Kunter-Bunt/masterthesis/thesis/titelseite.tex

%% Titelseite
%% Vorlage $Id: titelseite.tex 61 2012-05-03 13:58:03Z bless $

\def\usesf{}
\let\usesf\sffamily % diese Zeile auskommentieren für normalen TeX Font

\newsavebox{\Erstgutachter}
\savebox{\Erstgutachter}{\usesf Prof.~Dr.~H.~Schmeck}
\newsavebox{\Zweitgutachter}
\savebox{\Zweitgutachter}{\usesf Prof.~Dr.~?.~?????????}

\begin{titlepage}
\setlength{\unitlength}{1pt}
\begin{picture}(0,0)(85,770)

\end{picture}

\thispagestyle{empty}

%\begin{titlepage}
%%\let\footnotesize\small \let\footnoterule\relax
\begin{center}
\hbox{}
\vfill
{\usesf
{\huge\bfseries Zuverlässige funkbasierte Bereichsortung im Tunnelbau \par}
\vskip 1.8cm
Masterarbeit\\
von\\[2mm]
\vskip 1cm

{\large\bfseries Marius Wodtke\\}
\vskip 1.2cm
Institut für Angewandte Informatik und Formale Beschreibungsverfahren (AIFB)\\
der Fakultät für Informatik\\
%Universität Karlsruhe (TH)\\[2ex]
\vskip 3cm
\begin{tabular}{p{5.5cm}l}
Erstgutachter: & \usebox{\Erstgutachter} \\
%Zweitgutachter: & \usebox{\Zweitgutachter} \\
Betreuender~Mitarbeiter: & Dipl.-Inform.~K.~Bao \\
Externer Betreuer: & Andreas Ratzke (Ed. Züblin AG)\\
\end{tabular}
\vskip 3cm
Bearbeitungszeit:\qquad 02.~Oktober~2017 -- 11.~Januar~2018
}
\end{center}
\vfill
\end{titlepage}
%% Titelseite Ende

%%% Local Variables:
%%% mode: latex
%%% TeX-master: "thesis"
%%% End:
