Kunter-Bunt/masterthesis/thesis/iso-8859-1/titelseite.tex

%% Titelseite
%% Vorlage $Id: titelseite.tex 61 2012-05-03 13:58:03Z bless $

\def\usesf{}
\let\usesf\sffamily % diese Zeile auskommentieren für normalen TeX Font

\newsavebox{\Erstgutachter}
\savebox{\Erstgutachter}{\usesf Prof.~Dr.~?.~?????????}
\newsavebox{\Zweitgutachter}
\savebox{\Zweitgutachter}{\usesf Prof.~Dr.~?.~?????????}

\begin{titlepage}
\setlength{\unitlength}{1pt}
\begin{picture}(0,0)(85,770)

\end{picture}

\thispagestyle{empty}

%\begin{titlepage}
%%\let\footnotesize\small \let\footnoterule\relax
\begin{center}
\hbox{}
\vfill
{\usesf
{\huge\bfseries Hier steht der Titel der\\
                Diplom-/Studien-/Master-/""Bachelorarbeit \par}
\vskip 1.8cm
Diplomarbeit/Studienarbeit/Masterarbeit/Bachelorarbeit\\
von\\[2mm]
\vskip 1cm

{\large\bfseries Vorname Nachname\\}
\vskip 1.2cm
am Institut für Telematik\\
der Fakultät für Informatik\\
%Universität Karlsruhe (TH)\\[2ex]
\vskip 3cm
\begin{tabular}{p{5.5cm}l}
Erstgutachter: & \usebox{\Erstgutachter} \\
Zweitgutachter: & \usebox{\Zweitgutachter} \\
Betreuender~Mitarbeiter: & Dipl.-Inform.~?.~????????? \\
\end{tabular}
\vskip 3cm
Bearbeitungszeit:\qquad ??.~Monat~20?? -- ??.~Monat~20??
}
\end{center}
\vfill
\end{titlepage}
%% Titelseite Ende

%%% Local Variables: 
%%% mode: latex
%%% TeX-master: "thesis"
%%% End:
