Kunter-Bunt/masterthesis/thesis/iso-8859-1/einleitung.tex

%% Einleitung.tex
%% $Id: einleitung.tex 61 2012-05-03 13:58:03Z bless $
%%

\chapter{Einleitung}
\label{ch:Einleitung}
%% ==============================
Hinweis: In die Einleitung gehört die Motivation 
und Einleitung in die Problemstellung. Die Problemstellung
kann in der Analyse noch detaillierter beschrieben werden.

Bla fasel\ldots

%% ==============================
\section{Zielsetzung der Arbeit}
%% ==============================
\label{ch:Einleitung:sec:Zielsetzung}

Was ist die Aufgabe der Arbeit?

Bla fasel\ldots

%% ==============================
\section{Gliederung der Arbeit}
%% ==============================
\label{ch:Einleitung:sec:Gliederung}

Was enthalten die weiteren Kapitel?

Bla fasel\ldots

%%% Local Variables: 
%%% mode: latex
%%% TeX-master: "thesis"
%%% End:
