Kunter-Bunt/masterthesis/beamer/images/lis3dh.jpg

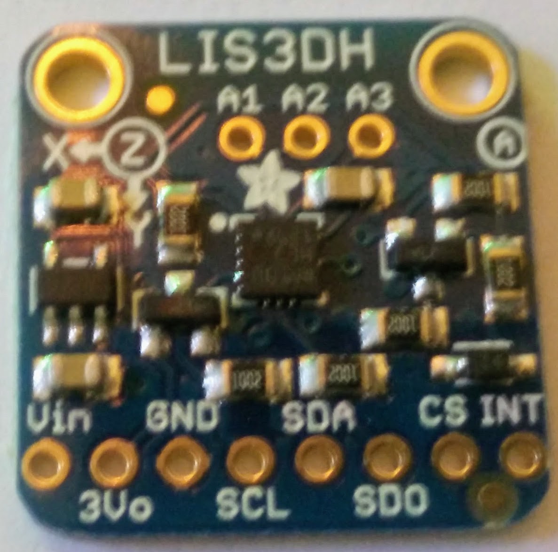
beamer/images/lis3dh.jpg
