Kunter-Bunt/masterthesis/beamer/images/lorafeather.jpg

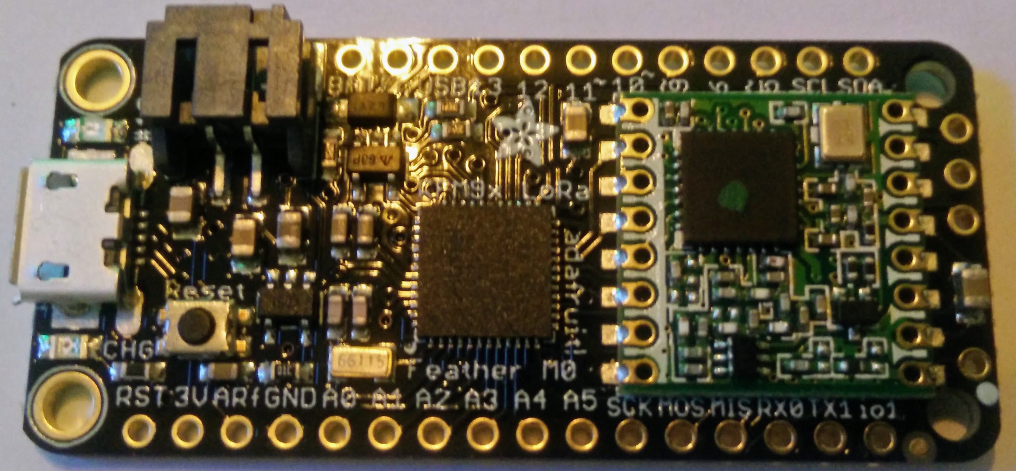
beamer/images/lorafeather.jpg
