Kunter-Bunt/masterthesis/beamer/images/nrf52layout.jpg

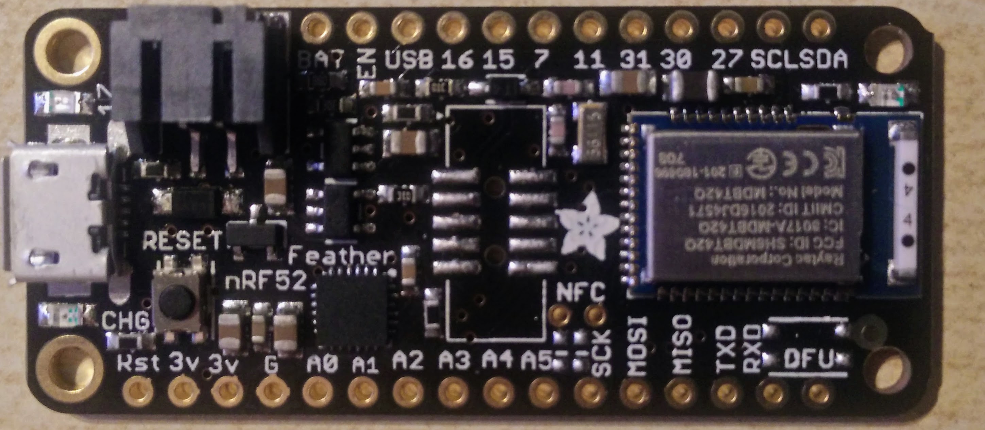
beamer/images/nrf52layout.jpg
