Kunter-Bunt/masterthesis/beamer/images/sendrecv.png

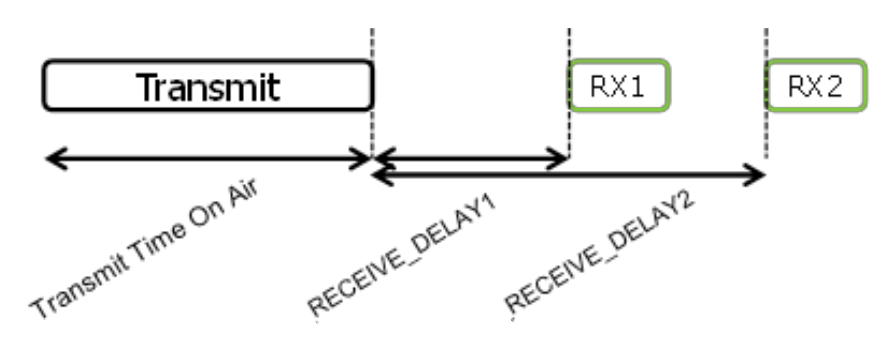
beamer/images/sendrecv.png
