Kunter-Bunt/masterthesis/beamer/plots/barcomp.png

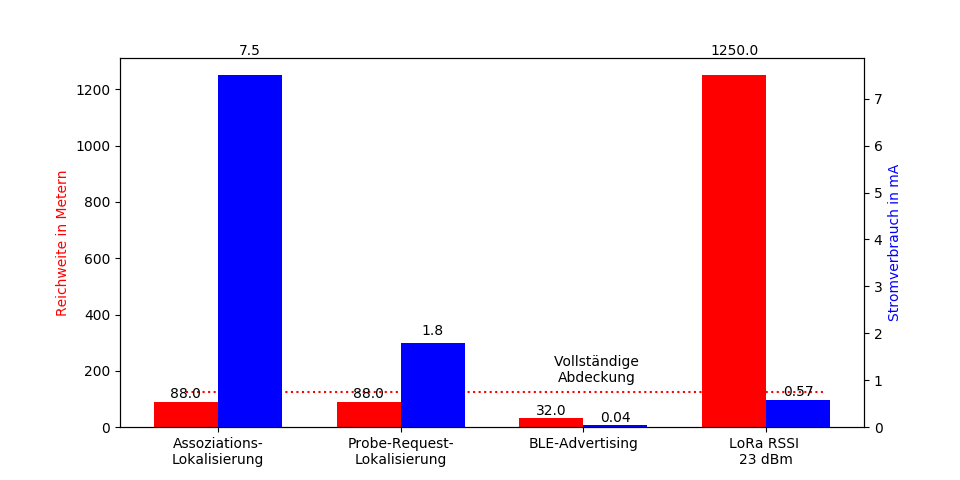
beamer/plots/barcomp.png
