Kunter-Bunt/masterthesis/beamer/plots/beacons.png

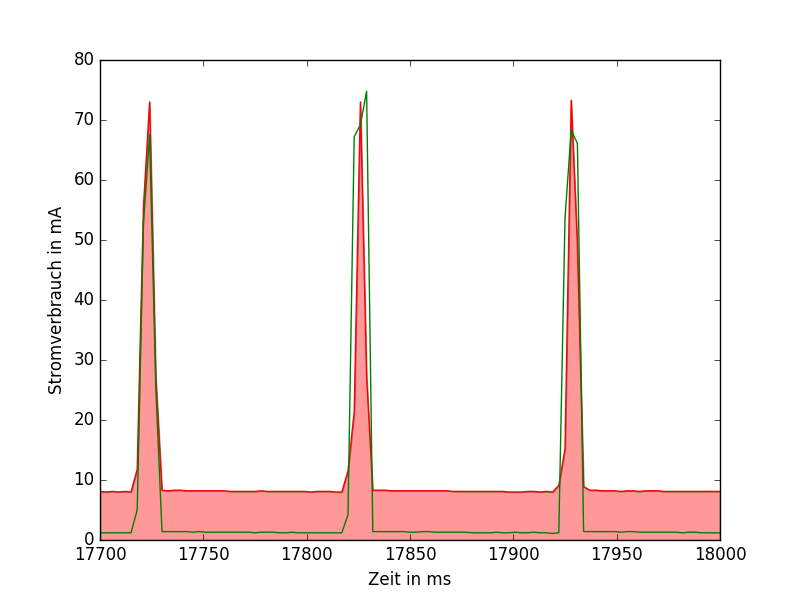
beamer/plots/beacons.png
