Kunter-Bunt/masterthesis/beamer/plots/llsalle.png

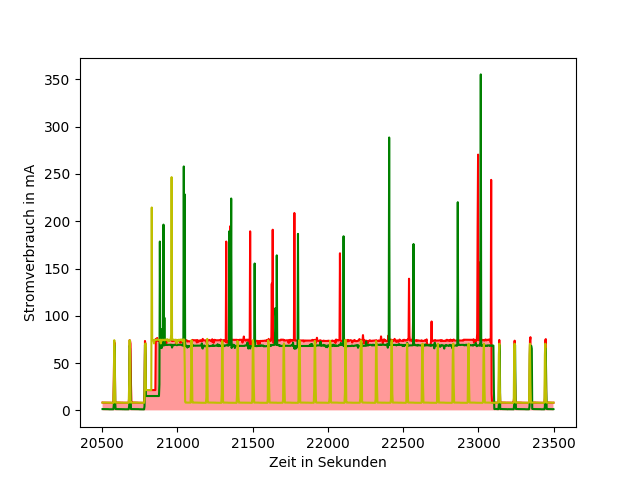
beamer/plots/llsalle.png
