Kunter-Bunt/masterthesis/beamer/plots/lora5send.png

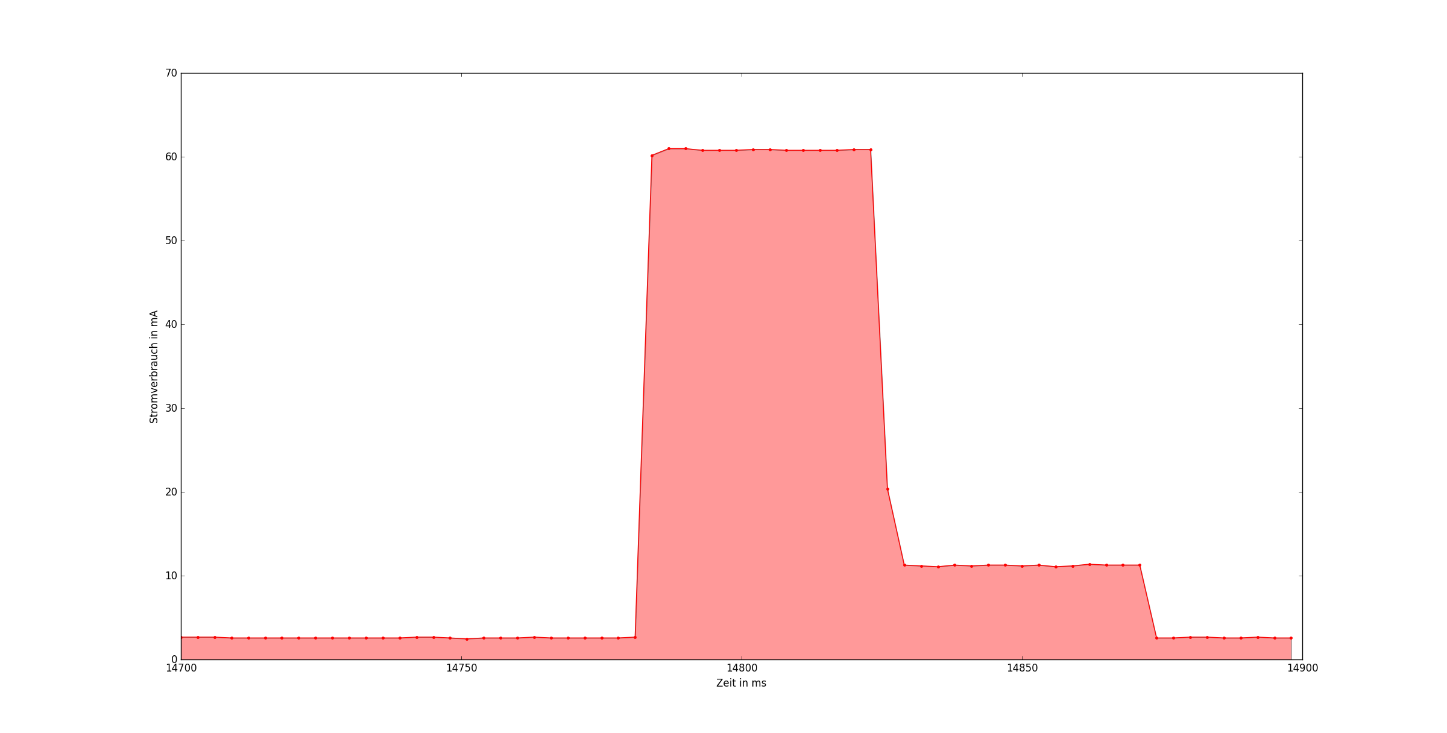
beamer/plots/lora5send.png
