Kunter-Bunt/masterthesis/beamer/plots/lora23send.png

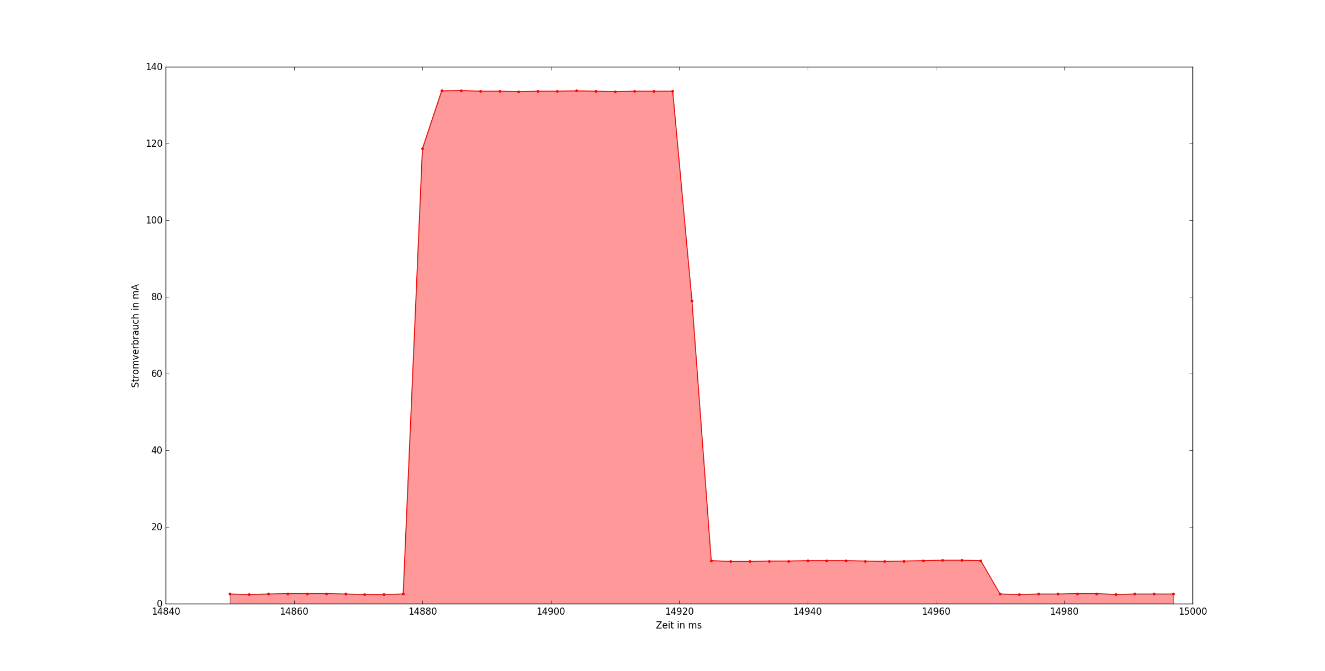
beamer/plots/lora23send.png
