Kunter-Bunt/masterthesis/beamer/plots/wifills1ch.png

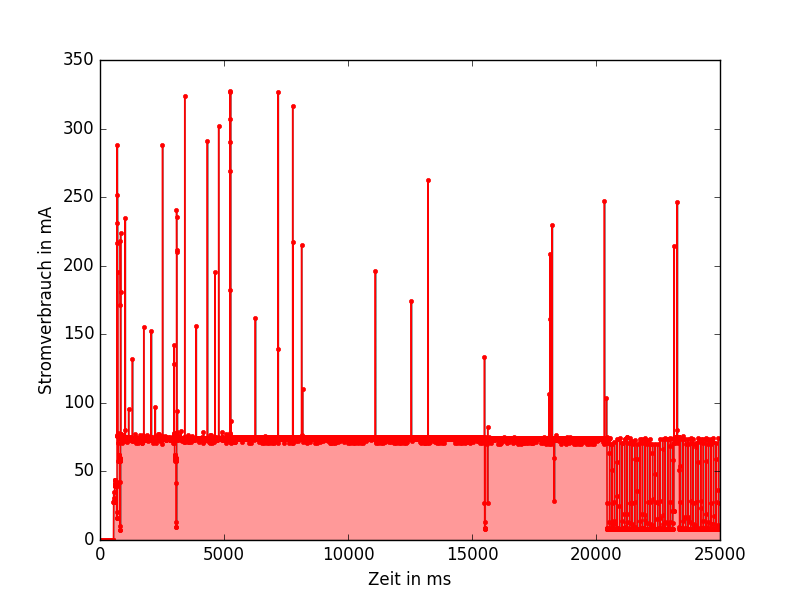
beamer/plots/wifills1ch.png
