Kunter-Bunt/masterthesis/thesis/ipes/resources/bluetooth-670069_640.png

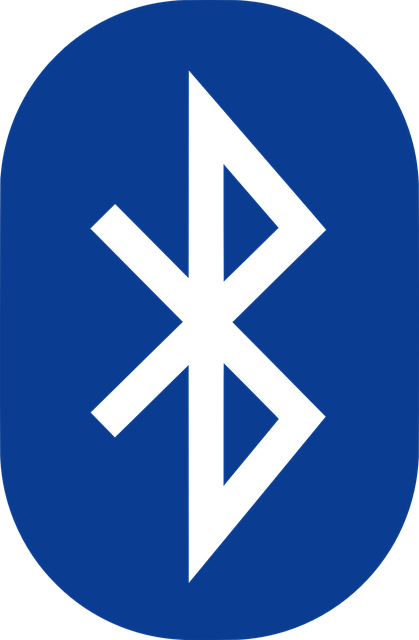
thesis/ipes/resources/bluetooth-670069_640.png
