Kunter-Bunt/masterthesis/thesis/ipes/resources/lora.png

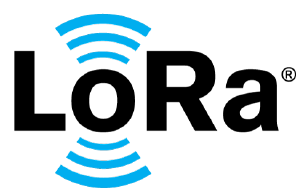
thesis/ipes/resources/lora.png
