Kunter-Bunt/masterthesis/thesis/ipes/resources/ondulating_arrow.png

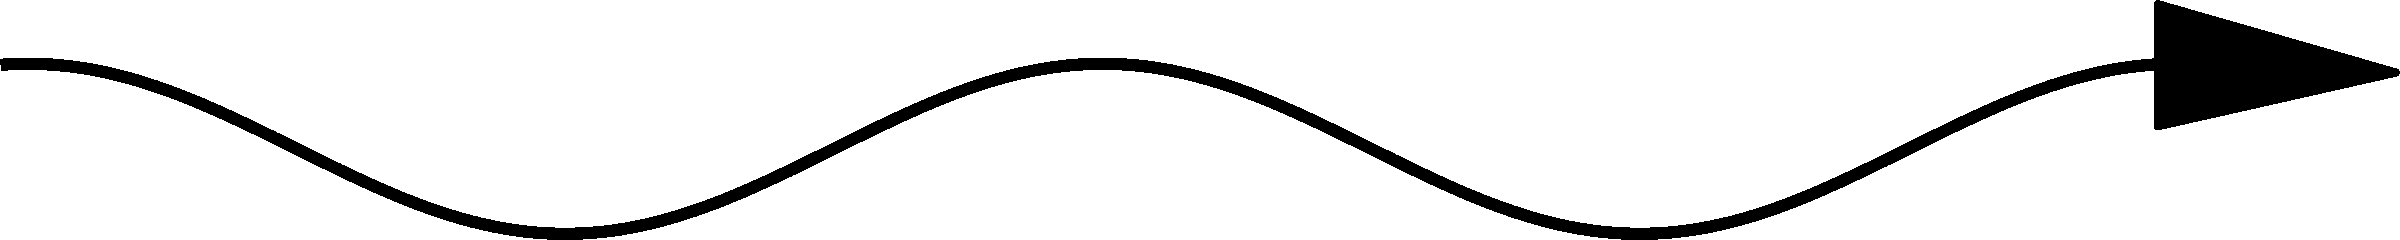
thesis/ipes/resources/ondulating_arrow.png
