Kunter-Bunt/masterthesis/4GehäuseBody.stl

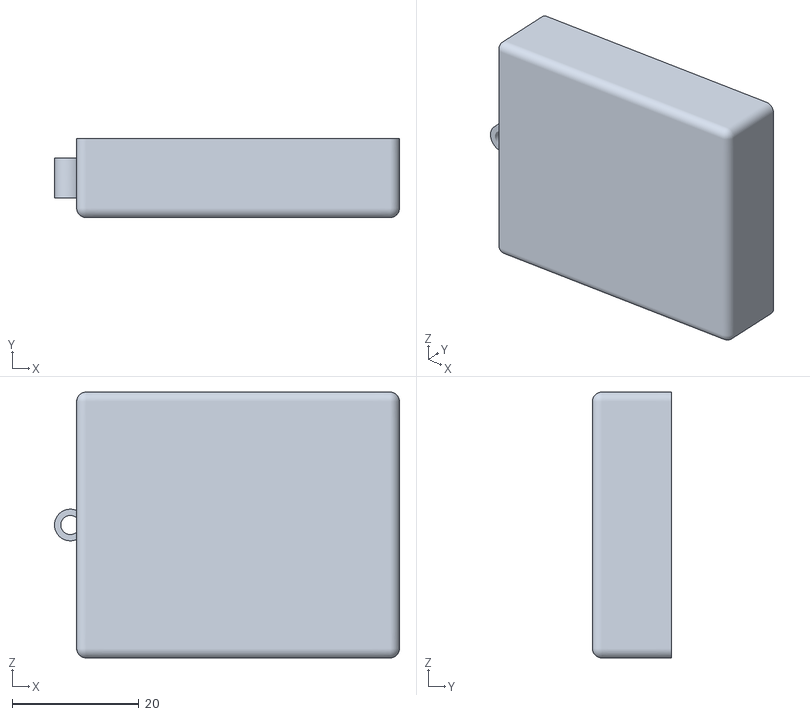
[picture p65: CAD file, 2018-06-02]
4GehäuseBody.stl
54.5 x 12.5 x 42.0
