Kunter-Bunt/masterthesis/4GehäuseTopCover.stl

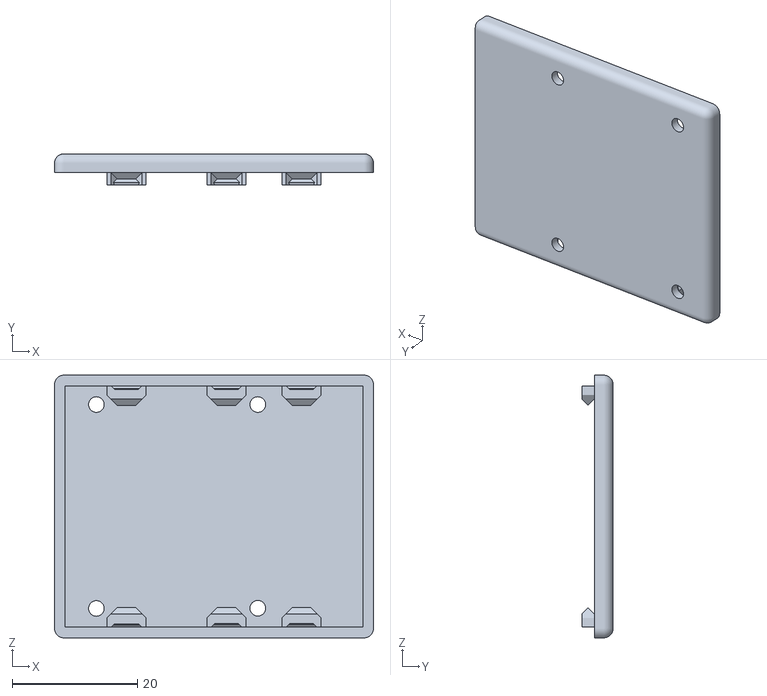
[picture p66: CAD file, 2018-06-02]
4GehäuseTopCover.stl
51.0 x 5.00 x 42.0
