Kunter-Bunt/masterthesis/CaseBase_Gehäuse v3_Enclosure_1_Case_1_Body3_Case.stl

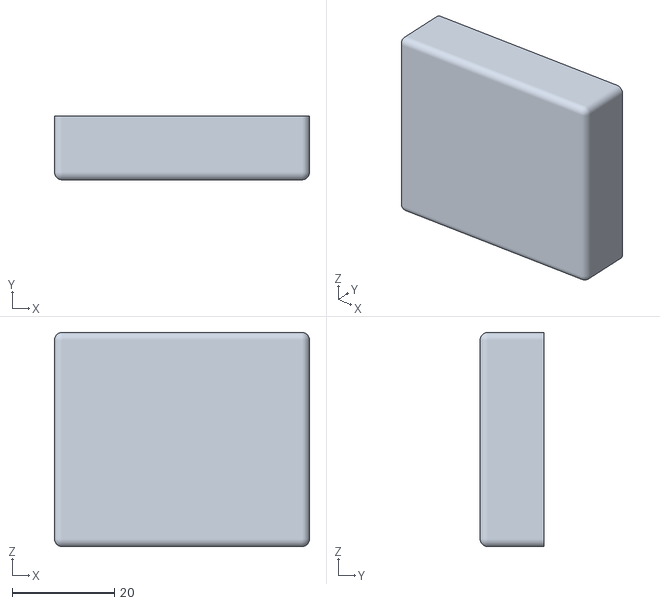
[picture p67: CAD file, 2018-02-24]
CaseBase_Gehäuse v3_Enclosure_1_Case_1_Body3_Case.stl
50.0 x 12.5 x 42.0
