Kunter-Bunt/masterthesis/TopCover_Gehäuse v3_Body1_TopCover.stl

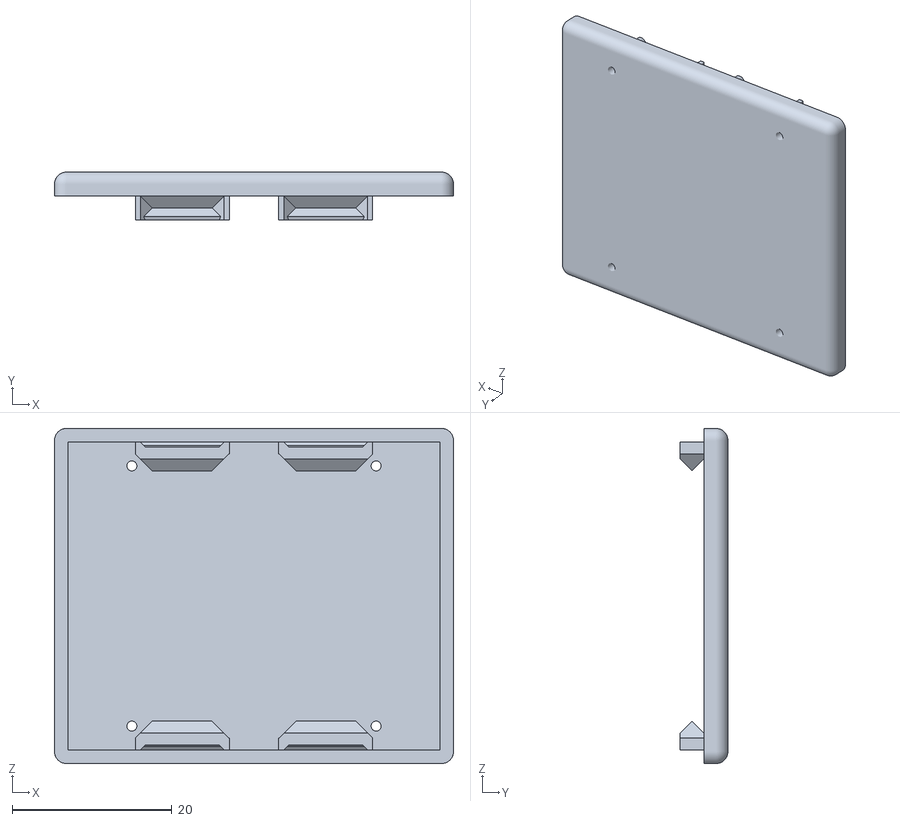
[picture p68: CAD file, 2018-02-24]
TopCover_Gehäuse v3_Body1_TopCover.stl
50.0 x 6.00 x 42.0
