Kunter-Bunt/masterthesis/3Gehaeuse.stl

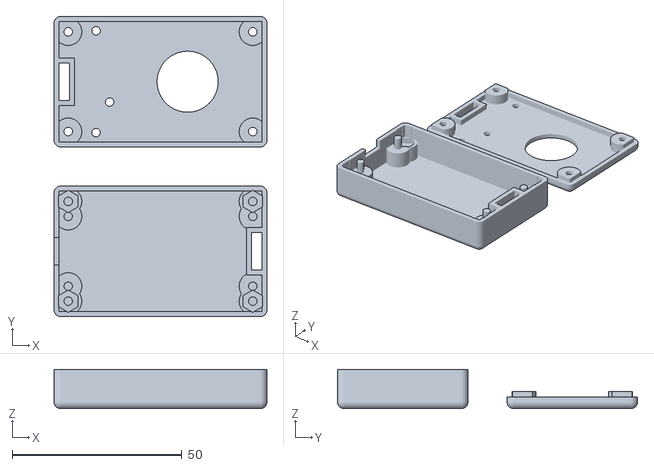
[picture p69: CAD file, 2018-01-07]
3Gehaeuse.stl
62.8 x 88.5 x 11.6
