Kunter-Bunt/masterthesis/2Gehaeuse.stl

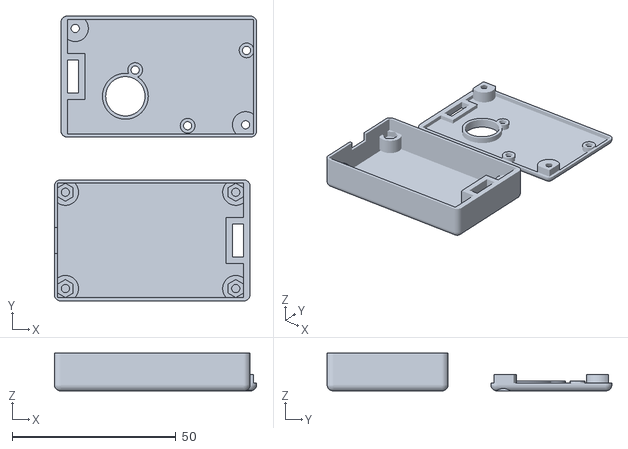
[picture p70: CAD file, 2017-12-16]
2Gehaeuse.stl
61.8 x 87.0 x 11.6
