Kunter-Bunt/masterthesis/Gehäuse.stl

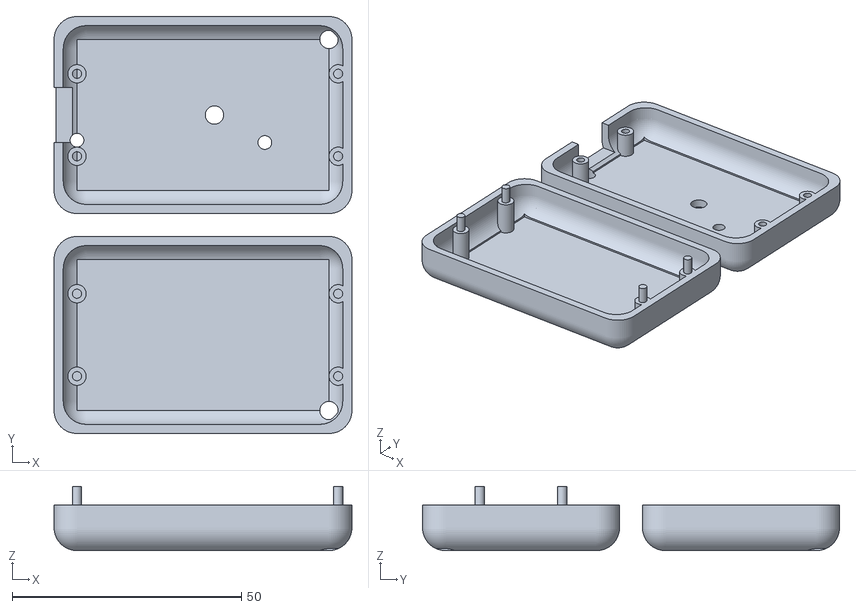
[picture p71: CAD file, 2017-11-15]
Gehäuse.stl
65.0 x 91.0 x 14.0
