Kunter-Bunt/masterthesis/WiFiTag/tag.brd

## EAGLE design WiFiTag/tag.brd (2018-08-04)

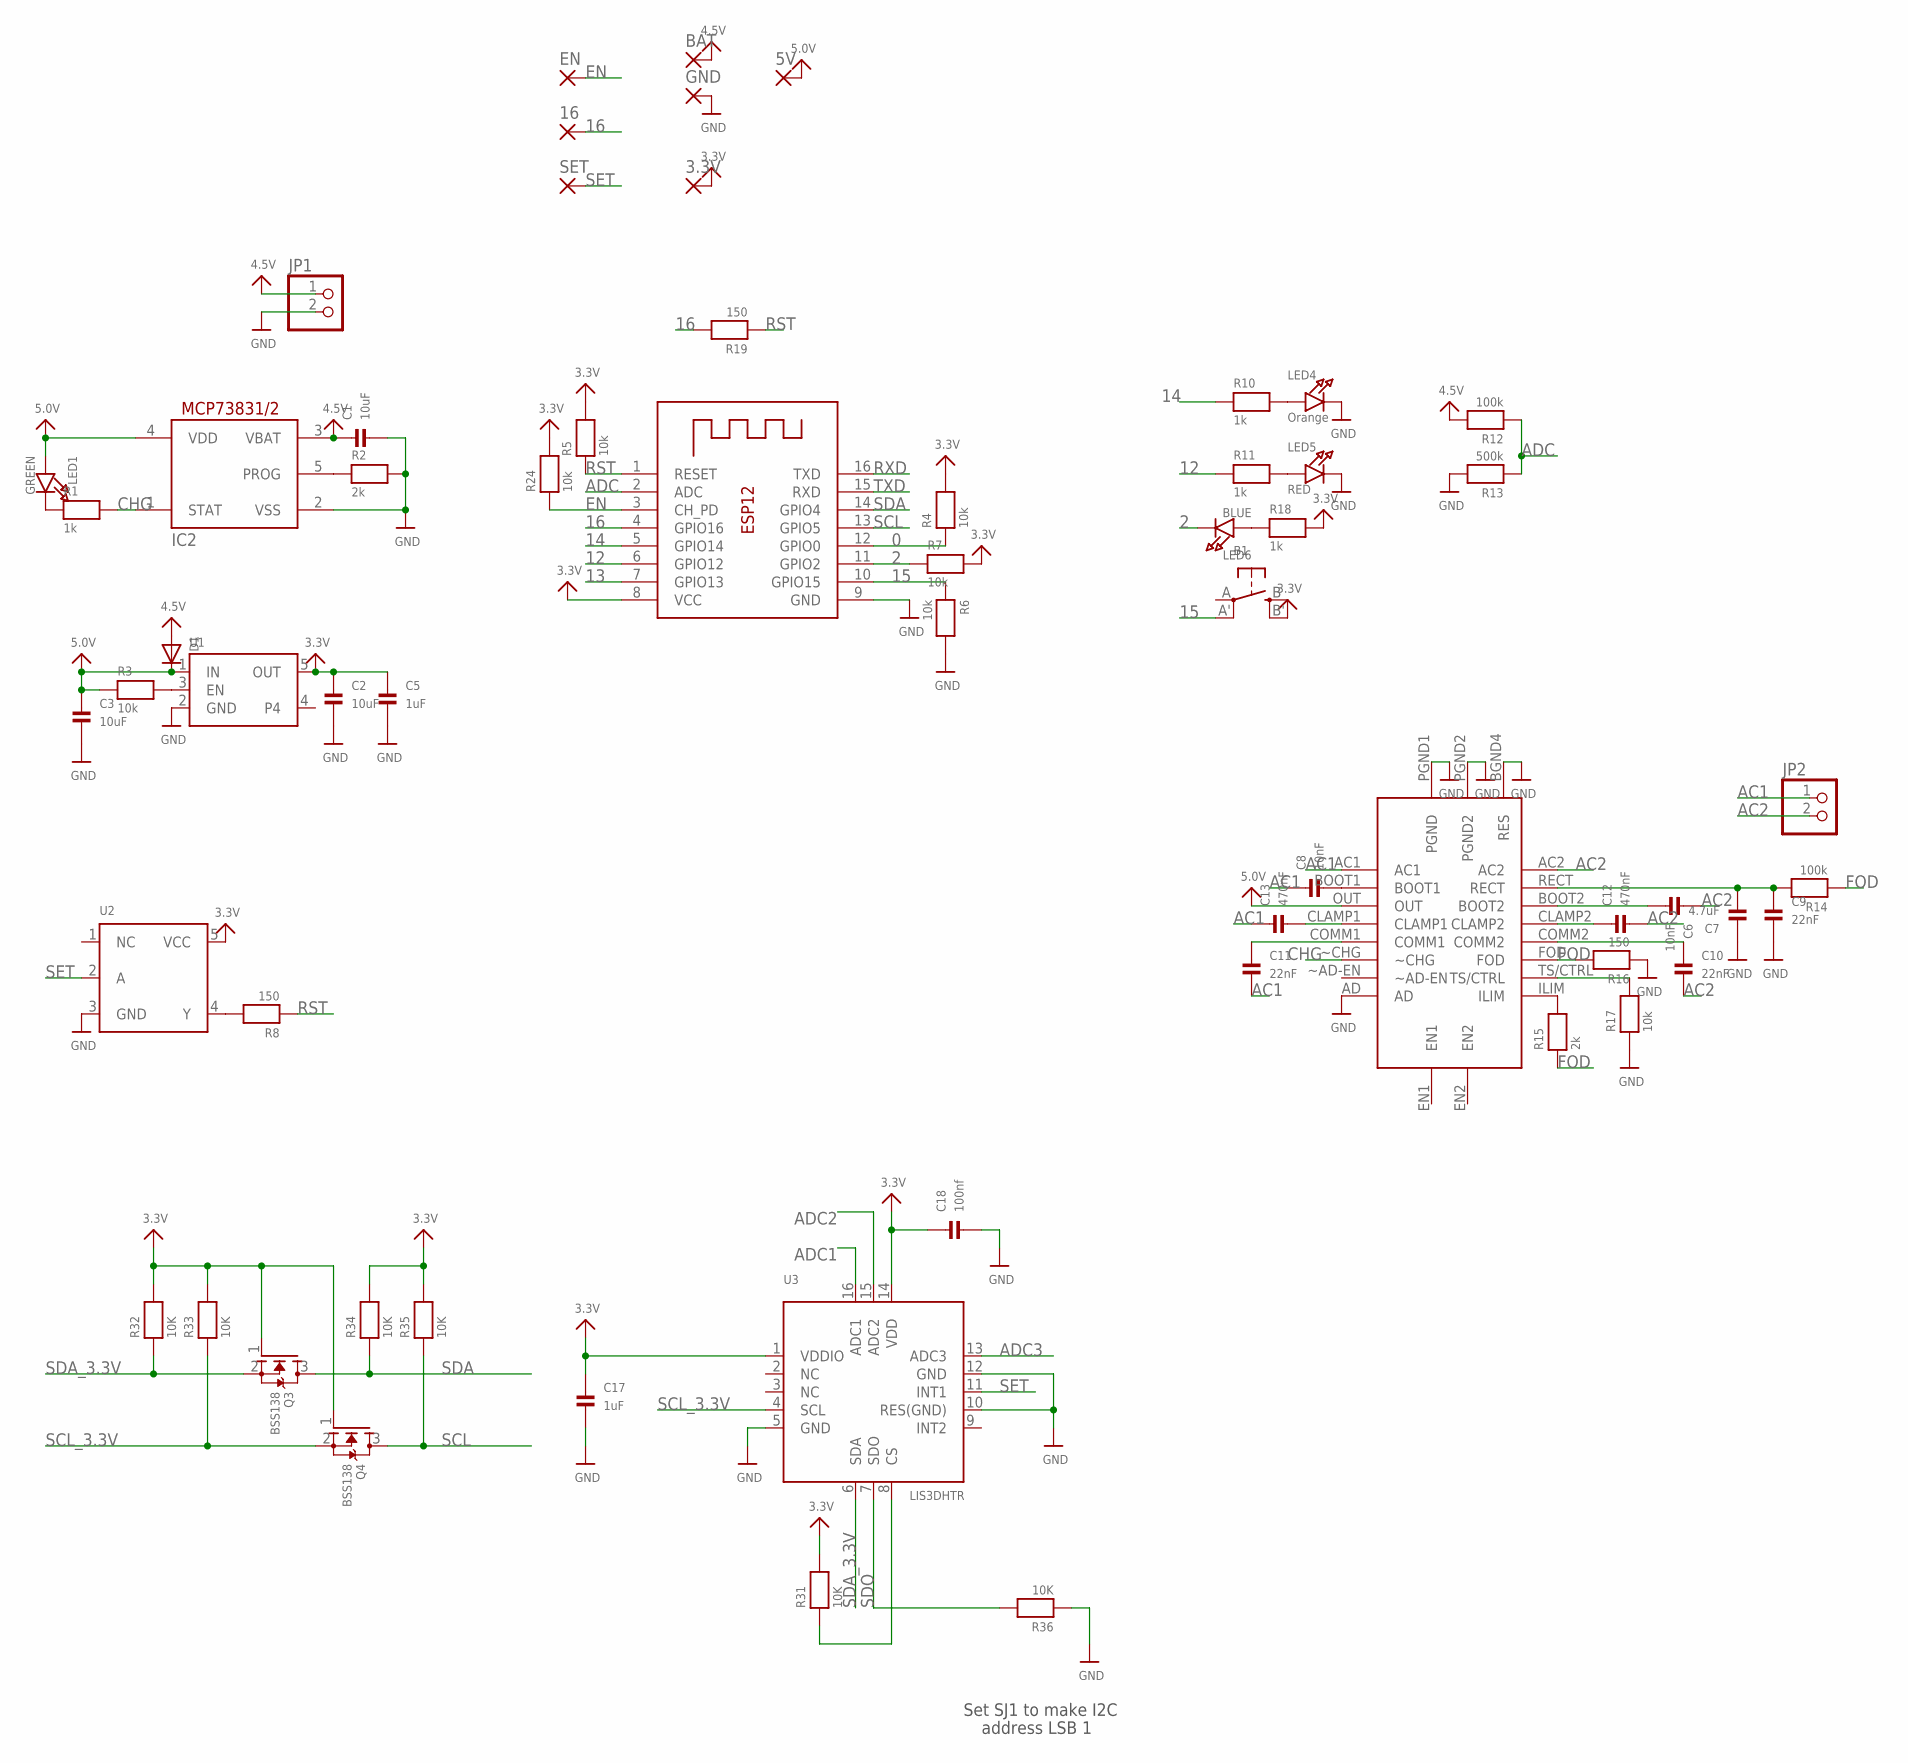
[picture p75: schematic tag.sch]

Parts:
3.3V, 5V, 16: SMD2; SMD1,27-2,54
B1: SWITCH_TACT_SMT4.6X2.8; BTN_KMR2_4.6X2.8
BAT: SMD2; SMD1,27-2,54
C1, C2, C3: 10uF; 0603
C5, C17: 1uF; 0402
C6, C8: 10nF; 0402
C7: 4.7uF; 0603
C9, C10, C11: 22nF; 0402
C12, C13: 470nF; 0402
C18: 100nf; 0402
D1: DIODESOD-123; SOD-123
EN: SMD2; SMD1,27-2,54
GND: SMD2; SMD1,27-2,54
IC2: MCP73831/OT; SOT23-5L
JP1, JP2: HEADER-1X2; 1X02_OVAL
LED1: GREEN; CHIPLED_0603
LED4: Orange; CHIPLED_0603
LED5: RED; CHIPLED_0603
LED6: BLUE; CHIPLED_0603
Q3, Q4: BSS138; SOT23-WIDE
R1, R10, R11, R18: 1k; 0402
R2, R15: 2k; 0402
R3, R4, R5, R6, R7, R17, R24: 10k; 0402
R8, R16, R19: 150; 0402
R12, R14: 100k; 0402
R13: 500k; 0402
R31, R32, R33, R34, R35, R36: 10K; 0402
SET: SMD2; SMD1,27-2,54
U1: VREG_SOT23-5; SOT23-5
U2: 74LVC1G04; SOT23-5
U3: LIS3DHTR; LGA16_3X3MM
U$1: BQ51013B; VQFN
X1: ESP-12

Connections:
0: R4.1, X1.12 (GPIO0)
2: LED6.C, R7.1, X1.11 (GPIO2)
3.3V: 3.3V.1, B1.B' (S1), C2.1, C5.1, C17.1, C18.1, Q3.1 (G), Q4.1 (G), R4.2, R5.2, R7.2, R18.2, R24.2, R31.2, R32.2, R33.2, R34.2, R35.2, U1.5 (OUT), U2.5 (VCC), U3.1 (VDDIO), U3.14 (VDD), X1.8 (VCC)
4.5V: BAT.1, C1.1, D1.A, IC2.3 (VBAT), JP1.1, R12.2
5.0V: 5V.1, C3.1, D1.C, IC2.4 (VDD), LED1.A, R3.1, U1.1 (IN), U$1.OUT
12: R11.1, X1.6 (GPIO12)
13: X1.7 (GPIO13)
14: R10.1, X1.5 (GPIO14)
15: B1.A' (P1), R6.1, X1.10 (GPIO15)
16: 16.1, R19.2, X1.4 (GPIO16)
AC1: C8.1, C11.2, C13.1, JP2.1, U$1.AC1
AC2: C6.1, C10.2, C12.2, JP2.2, U$1.AC2
ADC: R12.1, R13.1, X1.2 (ADC)
ADC1: U3.16 (ADC1)
ADC2: U3.15 (ADC2)
ADC3: U3.13 (ADC3)
CHG: IC2.1 (STAT), R1.2, U$1.~CHG
EN: EN.1, R24.1, X1.3 (CH_PD)
FOD: R14.1, R15.1, R16.2, U$1.FOD
GND: C1.2, C2.2, C3.2, C5.2, C7.1, C9.2, C17.2, C18.2, GND.1, IC2.2 (VSS), JP1.2, LED4.C, LED5.C, R2.2, R6.2, R13.2, R16.1, R17.1, R36.1, U1.2 (GND), U2.3 (GND), U3.5 (GND), U3.10 (RES(GND)), U3.12 (GND), U$1.AD, U$1.BGND4 (RES), U$1.PGND1 (PGND), U$1.PGND2, X1.9 (GND)
unnamed: C11.1, U$1.COMM1
unnamed: LED1.C, R1.1
unnamed: IC2.5 (PROG), R2.1
unnamed: LED6.A, R18.1
unnamed: R3.2, U1.3 (EN)
unnamed: R8.2, U2.4 (Y)
unnamed: R31.1, U3.8 (CS)
unnamed: LED4.A, R10.2
unnamed: LED5.A, R11.2
unnamed: C8.2, U$1.BOOT1
unnamed: C6.2, U$1.BOOT2
unnamed: C7.2, C9.1, R14.2, U$1.RECT
unnamed: R15.2, U$1.ILIM
unnamed: R17.2, U$1.TS/CTRL
unnamed: C10.1, U$1.COMM2
unnamed: C13.2, U$1.CLAMP1
unnamed: C12.1, U$1.CLAMP2
RST: R5.1, R8.1, R19.1, X1.1 (RESET)
RXD: X1.16 (TXD)
SCL: Q4.3 (D), R35.1, X1.13 (GPIO5)
SCL_3.3V: Q4.2 (S), R33.1, U3.4 (SCL)
SDA: Q3.3 (D), R34.1, X1.14 (GPIO4)
SDA_3.3V: Q3.2 (S), R32.1, U3.6 (SDA)
SDO: R36.2, U3.7 (SDO)
SET: SET.1, U2.2 (A), U3.11 (INT1)
TXD: X1.15 (RXD)

Notes on the sheet:
Set SJ1 to make I2C
address LSB 1

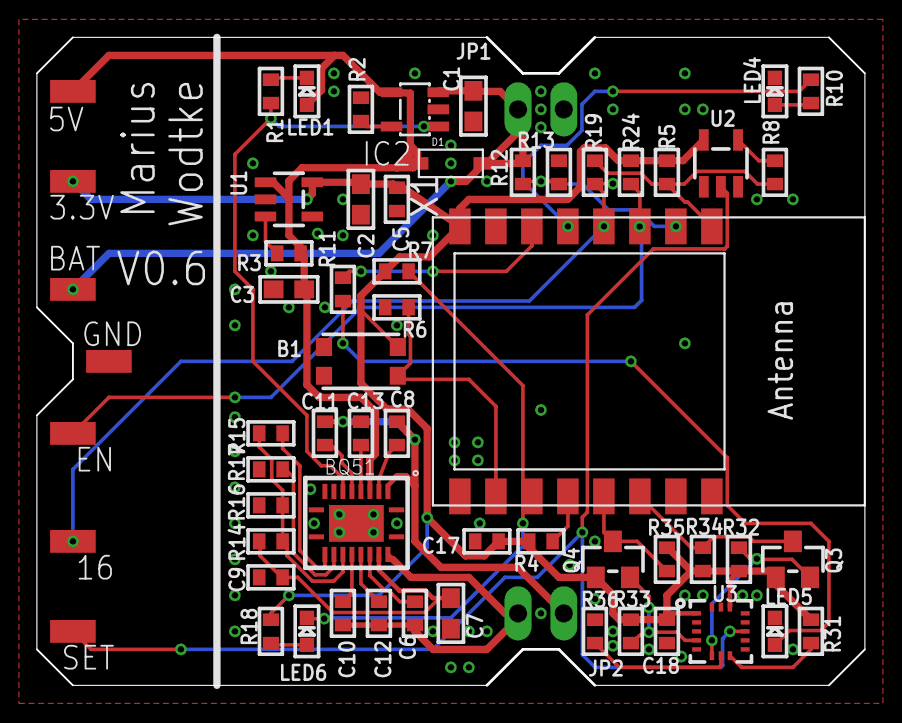
[picture p76: board tag.brd from above]

Board: 2 copper layers, 46.0 x 36.0 mm, 62 parts (0 on the bottom side), 40 nets.
