Kunter-Bunt/masterthesis/ESP-LIS3DH/esp-lis3dh.brd

## EAGLE design ESP-LIS3DH/esp-lis3dh.brd (2017-11-30)

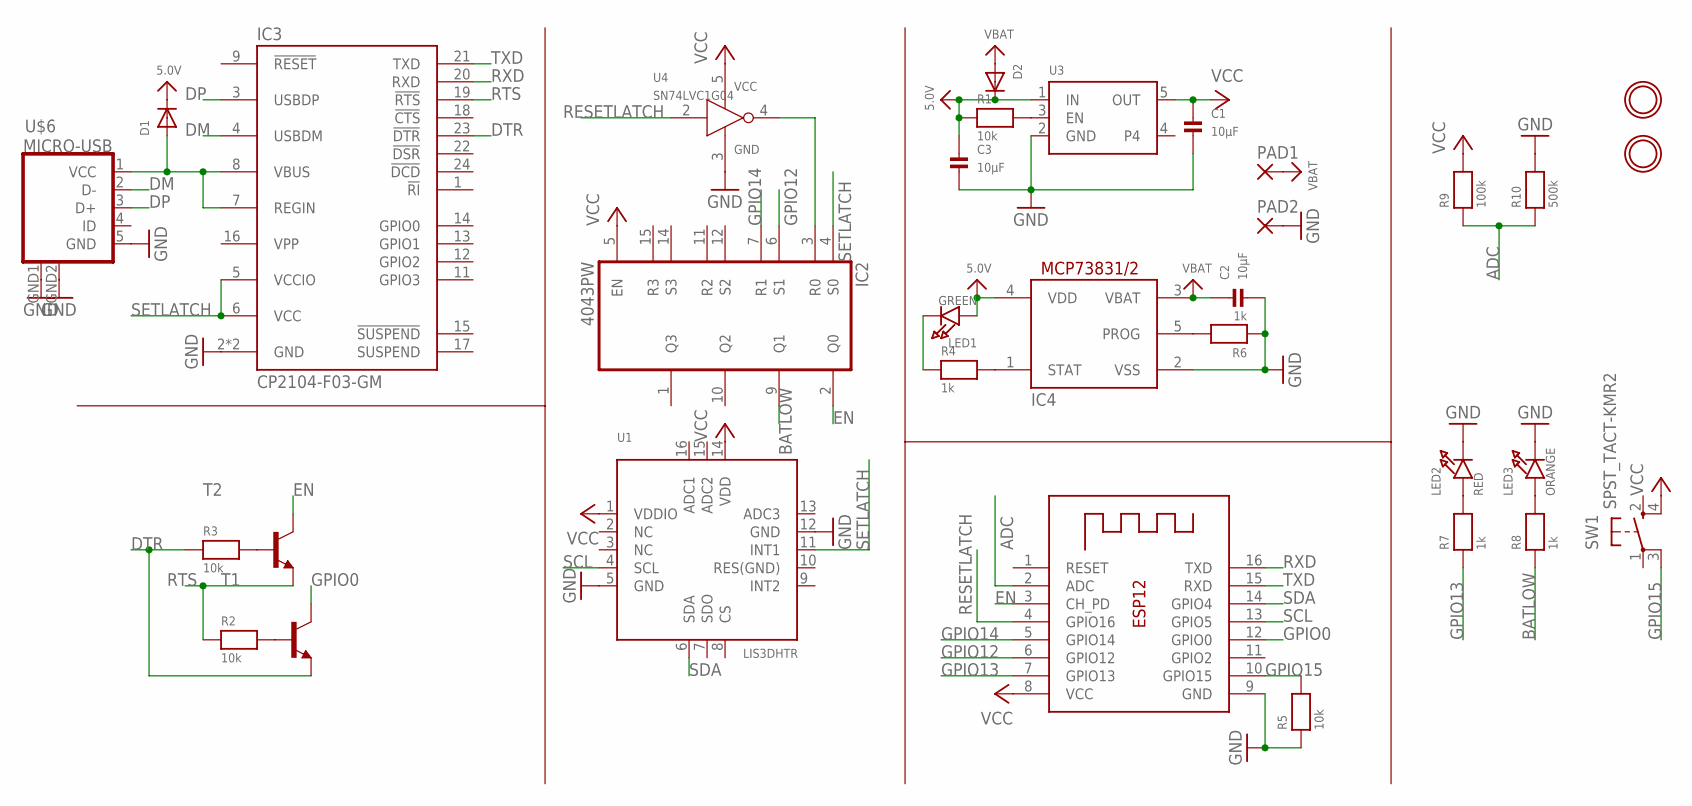
[picture p77: schematic esp-lis3dh.sch]

Parts:
C1, C2, C3: 10µF; 0805
D1, D2: DIODESOD-123; SOD-123
IC2: 4043PW; TSSOP16
IC3: CP2104-F03-GM; QFN24-PAD
IC4: MCP73831/OT; SOT23-5L
LED1: GREEN; CHIPLED_0805
LED2: RED; CHIPLED_0805
LED3: ORANGE; CHIPLED_0805
PAD1, PAD2: SMD2; SMD1,27-2,54
R1, R2, R3, R5: 10k; 0603
R4, R6, R7, R8: 1k; 0603
R9: 100k; 0603
R10: 500k; 0603
SW1: SPST_TACT-KMR2; KMR2
T1, T2: MMBT2222ALT1-NPN-SOT23-BEC; SOT23-BEC
U1: LIS3DHTR; LGA16_3X3MM
U3: VREG_SOT23-5; SOT23-5
U4: SN74LVC1G04; SOT23-5
U$6: MICRO-USB
U$7, U$8: MOUNTINGHOLE2.5; MOUNTINGHOLE_2.5_PLATED
X1: ESP-12

Connections:
5.0V: C3.1, D1.C, D2.C, IC4.4 (VDD), LED1.A, R1.1, U3.1 (IN)
ADC: R9.1, R10.1, X1.2 (ADC)
BATLOW: IC2.9 (Q1), R8.1
DM: IC3.4 (USBDM), U$6.2 (D-)
DP: IC3.3 (USBDP), U$6.3 (D+)
DTR: IC3.23 (!DTR), R3.1, T1.E
EN: IC2.2 (Q0), T2.C, X1.3 (CH_PD)
GND: C1.2, C2.2, C3.2, IC3.2 (GND), IC3.TP (GND), IC4.2 (VSS), LED2.C, LED3.C, PAD2.1, R5.1, R6.1, R10.2, U1.5 (GND), U1.12 (GND), U3.2 (GND), U4.3 (GND), U$6.5 (GND), U$6.GND1 (GND), U$6.GND2 (GND), X1.9 (GND)
GPIO0: T1.C, X1.12 (GPIO0)
GPIO12: IC2.6 (S1), X1.6 (GPIO12)
GPIO13: R7.1, X1.7 (GPIO13)
GPIO14: IC2.7 (R1), X1.5 (GPIO14)
GPIO15: R5.2, SW1.3 (P1), X1.10 (GPIO15)
unnamed: IC2.3 (R0), U4.4 (Y)
unnamed: IC4.5 (PROG), R6.2
unnamed: LED2.A, R7.2
unnamed: R1.2, U3.3 (EN)
unnamed: R2.2, T1.B
unnamed: IC4.1 (STAT), R4.2
unnamed: LED3.A, R8.2
unnamed: LED1.C, R4.1
unnamed: R3.2, T2.B
unnamed: D1.A, IC3.7 (REGIN), IC3.8 (VBUS), U$6.1 (VCC)
RESETLATCH: U4.2 (A), X1.4 (GPIO16)
RTS: IC3.19 (!RTS), R2.1, T2.E
RXD: IC3.20 (RXD), X1.16 (TXD)
SCL: U1.4 (SCL), X1.13 (GPIO5)
SDA: U1.6 (SDA), X1.14 (GPIO4)
SETLATCH: IC2.4 (S0), IC3.5 (VCCIO), IC3.6 (VCC), U1.11 (INT1)
TXD: IC3.21 (TXD), X1.15 (RXD)
VBAT: C2.1, D2.A, IC4.3 (VBAT), PAD1.1
VCC: C1.1, IC2.5 (EN), IC2.16 (VDD), R9.2, SW1.4 (S1), U1.1 (VDDIO), U1.14 (VDD), U3.5 (OUT), U4.5 (VCC), X1.8 (VCC)
VPP: IC3.16 (VPP)
VSS: IC2.8 (VSS)

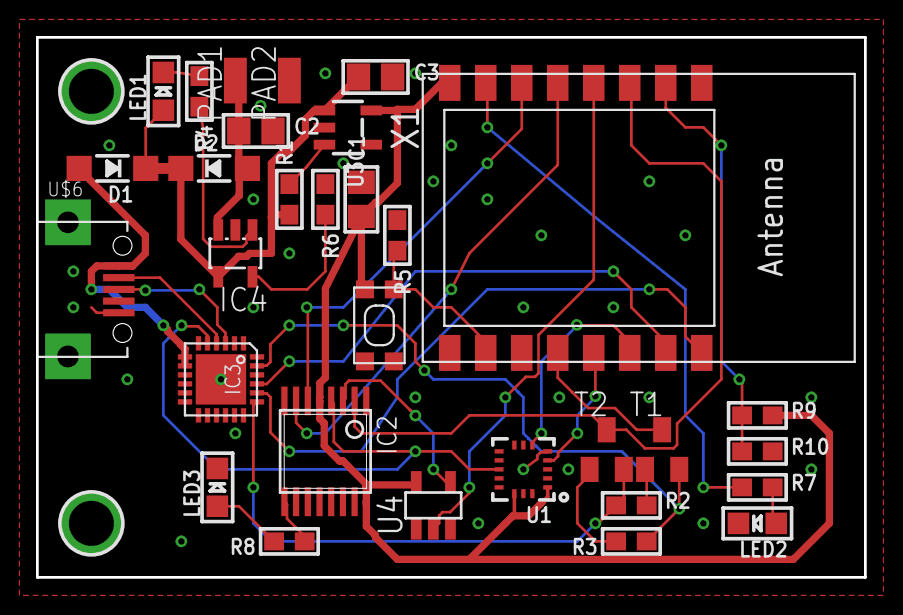
[picture p78: board esp-lis3dh.brd from above]

Board: 2 copper layers, 46.0 x 30.0 mm, 33 parts (0 on the bottom side), 32 nets.
