Kunter-Bunt/masterthesis/(commit log)

2016-12-14 added sketch with probe request utility
2017-01-26 added script for listening to probe requests
2017-02-15 added a sketch that should produce beacon frames (untested)
2017-02-15 modified probereq sketch to get desired functionality & added new fields for bssid on the tshark script
2017-02-17 Added support for single device monitoring on shark.sh
2017-02-17 Got rid of setup code to reduce power consumption
2017-02-17 Added sketch for quick testing battery life with loads of probe requests
2017-02-21 server now takes multiple file arguments and prints them like cat, but also works for streams, pipe output of commands to it with <(command), one thread per file, added thread support in makefile
2017-04-09 Added a c program that compies the probeReq sketch behavior
2017-04-14 Added programm for spamming, shortened packet to an absolute minimum, both the original and shorted are conserved in packet versions
    [probeReq.c]
2017-04-14 added the Makefile for probeReqSpam
2017-04-18 Added working sketch for a naiveTag for battery comparison
2017-05-08 Added a sketch that can read values and interrupts from LISD3H
2017-05-08 Added a sketch that turns a MOSFET on and of to control a current flow
2017-05-08 VccRead now properly reads the battery, cant read bat and chip vcc at the same time!
2017-05-08 Switching the network and cleaned up unnecessary code
2017-05-08 Switched to the short packet
    [probeReq.c]
2017-05-11 Added light sleep to naiveTag to reduce power consumption
2017-05-15 Added deviceless localization to Vorherige Arbeiten and a placeholder for Bluetooth-Localization
2017-05-15 Started new chapter Hrdware und Programmierung
2017-05-31 Shortened down the message of RADAR Tag for a fair comparasion, did not yield an improvement
    [RADARtag.ino]
2017-06-05 Added a server that accepts and print tcp data, client.py is for testing it
2017-06-05 Shrinked the probeReq packed buffer to save Memory
2017-06-10 Added smart tag functionality to probeReq
2017-06-10 Minor changes, VccRead now reads a button too
2017-06-25 Added some explanation about linear voltage regulators and updated text accordingly
2017-07-05 Added autoconnect to probeReq
2017-07-05 Added a probeReq Tag that can receive alarms through beacons
2017-07-05 Changed probeReq paket for short version
    [probeReq.ino]
2017-07-08 Changed Knoten to Basisstation
2017-07-17 Added the Feather componenets to the power calculation
2017-07-17 New chapter for accelerometer
2017-07-17 Changed the power class table, added citations
2017-07-17 Added a oneplus probereq packet to packet versions, probeReq Tag now uses this one
2017-08-03 Added new python servers for ProbeReq parsing. lanserver encodes Probe Requests, dbserver decodes them
2017-08-18 Added a sketch for measuring current with INA
2017-08-23 Added Power Consumption data
    [blue.csv, blue.raw.csv, lora23.csv, lora23.raw.csv, lora23send.csv, lora5.csv, lora5.raw.csv, lora5send.csv]
2017-08-23 Added a sket that does low power lora sending
2017-08-23 multiple chages to esp programms for testing power consumption
2017-08-23 added low power support for ble
2017-08-23 visualized the power consumtion data
2017-08-25 Added more plots
    [lora235send.csv, probeReq3chv.csv, wifillssendv.csv]
2017-08-31 moved the chapter lis3dh into the probereq chapter
2017-09-06 Added the section about no ap
    [beacons.csv, noap.csv, noap.raw.csv, noapopt.raw.csv, radarnoap.raw.csv]
2017-09-07 the new result csvs for lora
    [lora235sendneu.csv, lora23neu.csv, lora23neu.raw.csv, lora5neu.csv, lora5neu.raw.csv, proberequbersicht.csv]
2017-09-19 Added an overview for consumptions
    [alle.csv]
2017-09-20 noap got overlap, plotter now plots in seconds
    [noap.csv]
2017-09-20 Added a nomalization to power readings
2017-10-27 New plotter class for the beamer
    [probeReqNew.csv, wifillssendv.csv]
2017-10-27 Started hardware design
    [esp-lis3dh.brd, esp-lis3dh.sch]
2017-11-14 Small mistake in TDOA and added backup to beamer
    [plotter.py]
2017-11-15 Worked on pcb
    [esp-lis3dh.brd, esp-lis3dh.sch]
2017-11-15 Added the Gehäuse
    [Gehäuse.scad, Gehäuse.stl]
2017-11-30 Worked on prototype
    [esp-lis3dh.brd, esp-lis3dh.sch]
2017-11-30 Gerbers for prototype
    [esp-lis3dh.GBL, esp-lis3dh.GBO, esp-lis3dh.GBP, esp-lis3dh.GBS, esp-lis3dh.GTL, esp-lis3dh.GTO, esp-lis3dh.GTP, esp-lis3dh.GTS]
2017-11-30 Inductive charging prototype start
    [espind.brd, espind.sch]
2017-12-16 New housings for the tags
    [2Gehaeuse.scad, 2Gehaeuse.stl, 3Gehaeuse.scad, 3Gehaeuse.stl]
2017-12-16 NEW TAG PCB
    [espind.GBL, espind.GBO, espind.GBP, espind.GBS, espind.GTL, espind.GTO, espind.GTP, espind.GTS]
2018-01-07 3 Gehäuse printed version
    [3Gehaeuse.scad, 3Gehaeuse.stl]
2018-02-24 New board version 0.3
    [espind.GBL, espind.GBO, espind.GBP, espind.GBS, espind.GTL, espind.GTO, espind.GTP, espind.GTS]
2018-02-24 New case
    [CaseBase_Gehäuse v3_Enclosure_1_Case_1_Body3_Case.stl, TopCover_Gehäuse v3_Body1_TopCover.stl]
2018-04-14 new tag version 0.5
    [espind.brd, espind.sch, tag.brd, tag.sch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]
2018-04-27 XNOR Tag version
    [tag.brd, tag.csv, tag.sch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]
2018-06-02 V06 of PCB
    [tag.brd, tag.sch]
2018-06-02 New Gehäuse version
    [4GehäuseBody.stl, 4GehäuseTopCover.stl]
2018-08-04 Saving current wifitag state
    [tag.brd, tag.sch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]
